JustinBSG/USB_Hub_SS_1to3_Routing_Practice/usb_c_ss_hub_1to3_v1/docs/USB-C-SS-Hub-Hand-Solder-BOM.xlsx

Sheet: BOM
Case C BOM — R5 datasheet support audit | USB-C 5 V / 3 A | 3 × 0.50 A allocation
2026-11-02: added missing bias/divider/clock/strap resistors, DIR pull-ups and reset supervisor. Cgrst DNP; decouplers allocated. Startup ramp/inrush conflict remains OPEN; see Datasheet_Check. New prices TBD.
Item | Qty | Ref des | MPN | Mfr | Description | Package | Cat | Unit USD | Ext USD | DNP | Note
1 | 1 | U1 | TUSB8041ARGCR | Texas Instruments | 4-port USB 3.1 Gen1 SuperSpeed hub | VQFN-64 | DATA | $5.40 | $5.40 |  | Use individual power control; PWRCTL_POL low, FULLPWRMGMTz low, GANGED low. Battery-charging straps low. PWRCTL1–3 qualify TPS2552 EN via U35–37. Configure honest bus-powered power descriptors; 0.5 A hardware budget does not guarantee arbitrary USB3 high-power device compatibility. R5: R1bias/R1vbt/R1vbb/R1xfb added; TEST and PWRCTL_POL low via4.7k. U38 now drives GRSTz; Cgrst DNP.
2 | 1 | Y1 | ABM8-24.000MHZ-B2-T | Abracon | 24.000 MHz crystal ±20 ppm | 3.2×2.5 | DATA | $0.55 | $0.55 |  | Next to XI/XO. Away from L32.
3 | 2 | C_y | GRM1555C1H270JA01D | Murata | 27 pF C0G crystal load | 0402 | PASS | $0.03 | $0.06 |  | Two 27 pF → ~13.5 pF series + ~3 pF stray ≈ 16.5 pF. Crystal is 18 pF CL. Use 27 pF only after frequency validation, or try ~30 pF if measured stray is ~3 pF. Verify on prototype.
4 | 1 | U2 | HD3SS3220RNHR | Texas Instruments | UP0 CC + 10 Gbps 2:1 SS mux, PORT=UFP | WQFN-30 | CC | $1.85 | $1.85 |  | Upstream UFP: PORT=GND, ADDR NC (GPIO), VDD5=SYS_5V, VCC33=standby 3.3 V from U33. OUT2 pulled to standby 3.3 V: LOW means 3 A detected. U34 inverts OUT2 → EN of U31/U32. ENn_CC low; ENn_MUX=OUT2. VBUS_DET through 900 kΩ to J1 VBUS. R5: DIR pull-up Rdir2 to own VCC33.
5 | 1 | U3 | HD3SS3220RNHR | Texas Instruments | DS1 CC + SS mux, PORT=DFP | WQFN-30 | CC | $1.85 | $1.85 |  | DFP: PORT=SYS_5V; CURRENT_MODE explicitly LOW (Default USB); ADDR NC. ENn_CC=U2 OUT2 (disable without 3 A source). ID goes to corresponding U35–37 OR gate. VCC33=main 3.3 V; VDD5=SYS_5V. Passive-cable power budget; active/VCONN loads are outside guarantee. R5: DIR pull-up Rdir3 to own VCC33. PORT high through 4.7 kΩ; ENn_MUX directly GND for normal operation when main VCC33 active.
6 | 1 | U4 | HD3SS3220RNHR | Texas Instruments | DS2 CC + SS mux, PORT=DFP | WQFN-30 | CC | $1.85 | $1.85 |  | DFP: PORT=SYS_5V; CURRENT_MODE explicitly LOW (Default USB); ADDR NC. ENn_CC=U2 OUT2 (disable without 3 A source). ID goes to corresponding U35–37 OR gate. VCC33=main 3.3 V; VDD5=SYS_5V. Passive-cable power budget; active/VCONN loads are outside guarantee. R5: DIR pull-up Rdir4 to own VCC33. PORT high through 4.7 kΩ; ENn_MUX directly GND for normal operation when main VCC33 active.
7 | 1 | U5 | HD3SS3220RNHR | Texas Instruments | DS3 CC + SS mux, PORT=DFP | WQFN-30 | CC | $1.85 | $1.85 |  | DFP: PORT=SYS_5V; CURRENT_MODE explicitly LOW (Default USB); ADDR NC. ENn_CC=U2 OUT2 (disable without 3 A source). ID goes to corresponding U35–37 OR gate. VCC33=main 3.3 V; VDD5=SYS_5V. Passive-cable power budget; active/VCONN loads are outside guarantee. R5: DIR pull-up Rdir5 to own VCC33. PORT high through 4.7 kΩ; ENn_MUX directly GND for normal operation when main VCC33 active.
8 | 1 | U6 | TPS2552DBVR | Texas Instruments | 5 V port switch; 0.50 A allocated load | SOT-23-6 | POWER | $0.85 | $0.85 |  | Active-low EN from OR of corresponding HD3 ID and U1 active-low PWRCTL. External 10 kΩ EN pull-up to SYS_5V keeps port off when logic unpowered. FAULT to corresponding OVERCURz; no direct ID-only enable.
9 | 1 | U7 | TPS2552DBVR | Texas Instruments | 5 V port switch; 0.50 A allocated load | SOT-23-6 | POWER | $0.85 | $0.85 |  | Active-low EN from OR of corresponding HD3 ID and U1 active-low PWRCTL. External 10 kΩ EN pull-up to SYS_5V keeps port off when logic unpowered. FAULT to corresponding OVERCURz; no direct ID-only enable.
10 | 1 | U8 | TPS2552DBVR | Texas Instruments | 5 V port switch; 0.50 A allocated load | SOT-23-6 | POWER | $0.85 | $0.85 |  | Active-low EN from OR of corresponding HD3 ID and U1 active-low PWRCTL. External 10 kΩ EN pull-up to SYS_5V keeps port off when logic unpowered. FAULT to corresponding OVERCURz; no direct ID-only enable.
11 | 3 | Rilim | RC0603FR-0743K2L | Yageo | 43.2 kΩ 1%: identical downstream limits | 0603 | PASS | TBD | TBD |  | Three identical values. TI equations including 1% R: ~0.544–0.673 A threshold, nominal ~0.606 A. Normal-load allocation 0.50 A per port; limit is protection, not a USB current advertisement.
12 | 1 | U31 | TLV75533PDBVR | Texas Instruments | SYS_5V → 3.3 V LDO 500 mA, hand-solder | SOT-23-5 | POWER | $0.36 | $0.36 |  | SOT-23 retained. EN=U34 output, with 100 kΩ pulldown. Powers U1 and U3–U5 main 3.3 V; U2 uses separate standby supply. 0.20 A design allowance; thermal validation remains required.
13 | 1 | C31i | GRM188R60J106ME47D | Murata | 10 µF 6.3 V X5R ±20% LDO VIN | 0603 | PASS | $0.08 | $0.08 |  | Verified R6/X5R ordering code; −55 to +85 °C. Check effective capacitance at rail bias, tolerance and temperature. Existing price estimate only. Check 5 V bias curve against regulator input requirement.
14 | 1 | C31o | GRM21BR61A226ME51L | Murata | 22 µF 10 V X5R ±20% LDO VOUT | 0805 | PASS | $0.08 | $0.08 |  | Verified part shared with Cblk5. Changed 0603 → 0805; footprint update required. Check effective C at 3.3 V against TLV755P requirements. Existing $0.08 estimate reused.
15 | 1 | U32 | TLV62569PDDCR | Texas Instruments | SYS_5V → 1.1 V buck 2 A 1.5 MHz, hand-solder | SOT-23-6 | POWER | $0.62 | $0.62 |  | SOT-23 retained; EN=U34 output with 100 kΩ pulldown. Main 1.1 V powers only after upstream advertises 3 A. 1 µH +2×22 µF retained. PG participates in rail-qualified hub reset; recommended VIN max 5.5 V.
16 | 1 | L32 | XFL4020-102MEC | Coilcraft | 1.0 µH shielded Isat 5.4 A (30 % drop) / 4.5 A (10 % drop) | 4×4×2.1 mm | POWER | $1.15 | $1.15 |  | Verified XFL4020-102MEC. Isat figures are Coilcraft drop criteria. Check height vs original 4015. Start winding on SW.
17 | 1 | C32i | GRM188R60J106ME47D | Murata | 10 µF 6.3 V X5R ±20% buck VIN | 0603 | PASS | $0.08 | $0.08 |  | Verified R6/X5R ordering code; −55 to +85 °C. Check effective capacitance at rail bias, tolerance and temperature. Existing price estimate only. At U32 VIN/GND; check 5 V bias curve.
18 | 2 | C32o | GRM21BR61A226ME51L | Murata | 22 µF 10 V X5R ±20% buck VOUT (each) | 0805 | PASS | $0.08 | $0.16 |  | 2 × 22 µF with L32 = 1 µH: TLV62569 Table 4 tested combination for 0.6 ≤ VOUT < 1.2 V. Changed 0603 → 0805. Verify bias/temperature derating; table allows +20/−50% capacitor tolerance/derating.
19 | 1 | R32t | RC0402FR-07124KL | Yageo | 124 kΩ 1% FB top → 1.096 V | 0402 | PASS | $0.02 | $0.02 |  | Vout=0.6×(1+R1/R2).
20 | 1 | R32b | RC0402FR-07150KL | Yageo | 150 kΩ 1% FB bottom to AGND | 0402 | PASS | $0.02 | $0.02 |  | Place at U32, not at the hub.
21 | 1 | FB32 | BLM18PG300SN1D | Murata | Ferrite 30 Ω @100 MHz; DCR ≤50 mΩ | 0603 | PASS | $0.10 | $0.10 |  | Retained. Maximum DCR 0.05 Ω gives 35 mV drop at 0.70 A. Check 1.1 V rail margin including regulator tolerance, PCB drop and transients before selecting a lower-DCR alternative.
22 | 1 | C32h | GRM188R60J106ME47D | Murata | 10 µF 6.3 V X5R ±20% after ferrite | 0603 | PASS | $0.08 | $0.08 |  | Verified R6/X5R ordering code; −55 to +85 °C. Check effective capacitance at rail bias, tolerance and temperature. Existing price estimate only. Changed 0402 → 0603; footprint update required.
23 | 1 | Rpg | RC0402FR-07100KL | Yageo | 100 kΩ PG pull-up to 3.3 V | 0402 | PASS | $0.02 | $0.02 |  | 100 kΩ U32 PG pull-up to main3.3V; PG drives U38 MR, not directly U1 GRSTz. U38 adds release delay. Check PG threshold and hub-side 1.1 V margin.
24 | 0 | Cgrst | GRM155R71C105KA12D | Murata | 1 µF GRSTz to GND | 0402 | PASS | $0.04 | $0.00 | DNP | R5: omit original 1 µF GRSTz capacitor. U38 drives reset with a timed release; do not fit an extra large load on RESET.
25 | 1 | U30 | TPS259470ARPWR | Texas Instruments | Input eFuse: reverse blocking, slew control, adjustable OVP | VQFN-HR-10 | POWER | TBD | TBD |  | Replaces Q1; not pin-compatible. J1 VBUS → IN, OUT → SYS_5V. RILM=1.33 kΩ (~2.5 A); ITIMER open, AUXOFF NC. 100 nF dVdt gives ~0.25 s nominal rise at 5 V; verify maximum capacitance/startup. FLT pull-up to standby 3.3 V. QFN needs reflow/hot air. CORRECTION: 250 ms ramp is not acceptable for HD3 VDD5; see Component_Support.
26 | 1 | J1 | 124019572112A | Amphenol ICC | INPUT Type-C 24p mid-mount 5 A | Mid-mount | CONN | $2.27 | $2.27 |  | UP0. Parallel all VBUS and all GND pins.
27 | 1 | J2 | 124019572112A | Amphenol ICC | OUTPUT DS1 Type-C 24p mid-mount 5 A | Mid-mount | CONN | $2.27 | $2.27
28 | 1 | J3 | 124019572112A | Amphenol ICC | OUTPUT DS2 Type-C 24p mid-mount 5 A | Mid-mount | CONN | $2.27 | $2.27
29 | 1 | J4 | 124019572112A | Amphenol ICC | OUTPUT DS3 Type-C 24p mid-mount 5 A | Mid-mount | CONN | $2.27 | $2.27
30 | 16 | Uesd_ss | TPD2EUSB30DRTR | Texas Instruments | 2-ch low-C SS ESD (4 per Type-C for full coverage) | DRT (3-pin) | PROT | $0.42 | $6.72 |  | <1 mm from connector pads. Covers all 8 SS conductors per port.
31 | 4 | Uesd_cc | TPD4E05U06DQAR | Texas Instruments | 4-ch ESD D+/D−/CC1/CC2 | USON-10 | PROT | $0.38 | $1.52
32 | 4 | Dtv | PESD5V0S1UL | Nexperia | 5 V TVS on each Type-C VBUS (ESD only) | SOD882 / DFN1006-2 | PROT | $0.08 | $0.32 |  | Retained ESD-only. U30 adds OVLO disconnect (~5.38 V nominal); not a guarantee against every transient. Validate downstream overshoot.
33 | 16 | Cac | GCM155R71C104KA55D | Murata | 100 nF 16 V SS TX AC-cap | 0402 | PASS | $0.04 | $0.64 |  | 4 per port. Follow HD3SS3220 side-of-mux.
34 | 4 | R900k | RC0402FR-07900KL | Yageo | 900 kΩ VBUS_DET | 0402 | PASS | $0.02 | $0.08
35 | 3 | R200k | RC0402FR-07200KL | Yageo | 200 kΩ pull-up on DS ID | 0402 | PASS | $0.02 | $0.06
36 | 3 | Cblk5 | GRM21BR61A226ME51L | Murata | 22 µF 10 V downstream VBUS only (J2–J4) | 0805 | PASS | $0.08 | $0.24 |  | Remove 22 µF directly across upstream J1. Only three downstream capacitors here; J1 uses new C30in 1 µF.
37 | 1 | Cbulk | 16SVP180MX | Panasonic | 180 µF 16 V OS-CON SYS_5V | 8 mm | PASS | $0.85 | $0.85 |  | 180 µF after U30, never directly on J1 VBUS. Include all SYS_5V capacitance in inrush test; main regulators/ports disabled until 3 A detected.
38 | 20 | C10u | GRM188R60J106ME47D | Murata | 10 µF 6.3 V X5R ±20% local decouple | 0603 | PASS | $0.08 | $1.60 |  | R5 planning allocation: U1 two rail bulk caps; U2–U5 two each (VCC33/VDD5), total10. Remaining10 retained as existing reserve, not required by this allocation. Exact DC-bias effective C and any VCONN bulk need validation.
39 | 26 | C100n | GRM155R71C104KA88D | Murata | 100 nF 16 V per power pin | 0402 | PASS | $0.02 | $0.52 |  | R5 allocated: U1=12 (8 VDD +4 VDD33); U2–U5=8 (VCC33/VDD5 each); U6–U8=6 (IN/OUT each). Total26, previously24. Logic C34–37 and supervisor C38 are separate rows.
40 | 1 | PCB | JLC04161H-7628 ENIG + stencil | JLCPCB | 4-layer 1.0 mm (preferred for mid-mount), 90 Ω coupon, ~80×50 mm | 4-layer | MECH | $18.00 | $18.00 |  | Mid-mount connector prefers 0.8–1.2 mm. Confirm drawing or change thickness.
41 | 4 | MH | R30-1000402 | Harwin | M3 female-female brass spacer 4 mm (screw not included) | M3 | MECH | $0.40 | $1.60 |  | Harwin R30-1000402 is the spacer only. Specify separate M3 screws if required.
42 | 1 | U33 | TPS70933DBVR | Texas Instruments | Standby 3.3 V LDO for U2 and U34 | SOT-23-5 | POWER | TBD | TBD |  | IN=SYS_5V, EN open per TI; OUT=3V3_STBY. Runs before U31/U32. Check <100 mA startup/standby budget.
43 | 1 | U34 | SN74LVC1G04DBVR | Texas Instruments | 3 A detection inverter | SOT-23-5 | CC | TBD | TBD |  | Powered by 3V3_STBY. Input=U2 OUT2, output=MAIN_ENABLE to U31/U32 EN. OUT2 high/default → off. Loss of 3 A disables main rails.
44 | 3 | U35,U36,U37 | SN74LVC1G32DBVR | Texas Instruments | Per-port ID OR active-low hub PWRCTL | SOT-23-5 | CC | TBD | TBD |  | Powered by main 3.3 V. ENn_i = ID_i OR PWRCTLn_i. Ioff support and external EN pull-ups required. Both inputs must be low to enable port.
45 | 1 | R30ilim | RC0603FR-071K33L | Yageo | 1.33 kΩ 1% eFuse current setting | 0603 | PASS | TBD | TBD |  | Nominal ~2.50 A, tolerance budget ~2.23–2.78 A incl 1% resistor. No guarantee to limit sub-microsecond peaks.
46 | 1 | R30ovt | RT0603BRD0734K8L | Yageo | 34.8 kΩ 0.1% OVLO top resistor | 0603 | PASS | TBD | TBD |  | J1 VBUS to OVLO. With 10 kΩ bottom: nominal 5.376 V; ~5.292–5.488 V using TI threshold and resistor tolerance (before leakage/transients).
47 | 1 | R30ovb | RT0603BRD0710KL | Yageo | 10 kΩ 0.1% OVLO bottom resistor | 0603 | PASS | TBD | TBD |  | OVLO to GND. Disconnects excessive input; no higher-voltage USB-PD negotiation.
48 | 1 | R30uvt | RC0603FR-0747KL | Yageo | 47 kΩ 1% input UVLO top | 0603 | PASS | TBD | TBD |  | J1 VBUS to EN/UVLO; with 20 kΩ bottom ~4.02 V rising.
49 | 1 | R30uvb | RC0603FR-0720KL | Yageo | 20 kΩ 1% input UVLO bottom | 0603 | PASS | TBD | TBD |  | EN/UVLO to GND. U30 starts independently of main enable to power U2 detection.
50 | 1 | C30dvdt | GRM155R71C104KA88D | Murata | 100 nF eFuse slew capacitor | 0402 | PASS | $0.02 | $0.02 |  | REVIEW REQUIRED: R4 100 nF dVdt gives ~250 ms nominal 5 V rise, conflicting with HD3SS3220 VDD5 ramp maximum 25 ms. Revise slew capacitor or supply sequencing and verify inrush before release.
51 | 1 | C30in | GRM155R71C105KA12D | Murata | 1 µF 16 V upstream input capacitor | 0402 | PASS | $0.04 | $0.04 |  | At J1/U30 input. Total raw VBUS capacitance must stay within USB attach limit; no 22 µF or bulk before U30.
52 | 1 | C33in | GRM155R71C105KA12D | Murata | 1 µF 16 V standby LDO input | 0402 | PASS | $0.04 | $0.04 |  | U33 IN to GND, after U30.
53 | 1 | C33out | GRM21BR61A226ME51L | Murata | 22 µF 10 V standby LDO output | 0805 | PASS | $0.08 | $0.08 |  | U33 OUT to GND; verify effective capacitance ≥2 µF and ESR against TPS709 requirements.
54 | 4 | C34,C35,C36,C37 | GRM155R71C104KA88D | Murata | 100 nF logic decoupling | 0402 | PASS | $0.02 | $0.08 |  | One at each logic IC supply.
55 | 5 | Rout2,Rflt30,Ren6,Ren7,Ren8 | RC0603FR-0710KL | Yageo | 10 kΩ 1% fail-safe pull-ups | 0603 | PASS | TBD | TBD |  | OUT2/FLT30 to standby 3.3 V; TPS2552 EN pins to SYS_5V.
56 | 2 | Ren31,Ren32 | RC0603FR-07100KL | Yageo | 100 kΩ 1% main-enable pulldowns | 0603 | PASS | TBD | TBD |  | EN of each main regulator to GND.
57 | 1 | R1bias | RC0603FR-079K53L | Yageo | 9.53 kΩ 1% USB reference resistor | 0603 | PASS | TBD | TBD |  | U1 USB_R1 pin 64 to GND; mandatory. TI pin functions and Fig.34. Close to IC.
58 | 1 | R1vbt | RC0603FR-0790K9L | Yageo | 90.9 kΩ 1% upstream VBUS divider top | 0603 | PASS | TBD | TBD |  | J1 VBUS → R1vbt → U1 USB_VBUS pin 48. Mandatory; distinct from HD3 VBUS_DET.
59 | 1 | R1vbb | RC0603FR-0710KL | Yageo | 10 kΩ 1% upstream VBUS divider bottom | 0603 | PASS | TBD | TBD |  | U1 USB_VBUS pin 48 to GND. 5 V input gives ~0.496 V; never connect pin directly to 5 V.
60 | 1 | R1xfb | RC0603FR-071ML | Yageo | 1 MΩ crystal feedback resistor | 0603 | PASS | TBD | TBD |  | Across U1 XI and XO, in parallel with Y1; follows TI Fig.34 crystal implementation.
61 | 2 | R1test,R1pol | RC0603FR-074K7L | Yageo | 4.7 kΩ explicit low straps | 0603 | PASS | TBD | TBD |  | R1test: U1 TEST pin49 to GND (TI Fig.34). R1pol: PWRCTL_POL pin41 to GND for active-low port power control. FULLPWRMGMTz/GANGED use internal pulldowns; charging straps use internal pulldowns.
62 | 4 | Rdir2,Rdir3,Rdir4,Rdir5 | RC0402FR-07200KL | Yageo | 200 kΩ DIR pull-ups for all USB-C muxes | 0402 | PASS | $0.02 | $0.08 |  | Each HD3 DIR pin11 to its own VCC33 rail: U2 standby; U3–U5 main. Datasheet explicitly requires DIR pull-up even if DIR not routed elsewhere.
63 | 3 | Rport3,Rport4,Rport5 | RC0603FR-074K7L | Yageo | 4.7 kΩ DFP PORT pull-ups | 0603 | PASS | TBD | TBD |  | U3/U4/U5 PORT pin4 to SYS_5V, per tri-level pull-up guidance. U2 PORT directly GND. CURRENT_MODE U3–U5 directly GND; ADDR open in GPIO mode.
64 | 1 | U38 | TPS3808G33DBVR | Texas Instruments | 3.3 V reset supervisor with manual-reset input | SOT-23-6 | POWER | TBD | TBD |  | VDD and SENSE to main3.3V; MR to U32 PG (Rpg pull-up retained); RESET to U1 GRSTz. CT open gives 12–28 ms delay (20 ms typical) after 3.3 V good and PG released. Verify hub-side 1.1 V including ferrite/drop; PG is not a precise remote rail monitor.
65 | 1 | R38reset | RC0603FR-0710KL | Yageo | 10 kΩ supervisor RESET pull-up | 0603 | PASS | TBD | TBD |  | U38 RESET/U1 GRSTz to main3.3V. Remove Cgrst from assembly; CT left open.
66 | 1 | C38 | GRM155R71C104KA88D | Murata | 100 nF U38 local supply bypass | 0402 | PASS | $0.02 | $0.02 |  | U38 VDD to GND close to pins; separate from the general C100n pool.
 |  |  |  |  |  |  | BOARD TOTAL |  | QUOTE REQUIRED
 |  |  |  |  |  |  | PRICED SUBTOTAL |  | 60.32
Category | Priced USD subtotal
DATA | 5.95
CC | 7.4
POWER | 4.68
PROT | 8.56
CONN | 9.08
PASS | 5.05
MECH | 19.6

Sheet: Buy_List
R5 purchase list — DNP excluded; new prices require quotes
MPN | Mfr | Total qty | Unit USD | Ext USD | Used on
TUSB8041ARGCR | Texas Instruments | 1 | $5.40 | $5.40 | U1
ABM8-24.000MHZ-B2-T | Abracon | 1 | $0.55 | $0.55 | Y1
GRM1555C1H270JA01D | Murata | 2 | $0.03 | $0.06 | C_y
HD3SS3220RNHR | Texas Instruments | 4 | $1.85 | $7.40 | U2, U3, U4, U5
TPS2552DBVR | Texas Instruments | 3 | $0.85 | $2.55 | U6, U7, U8
RC0603FR-0743K2L | Yageo | 3 | TBD | TBD | Rilim
TLV75533PDBVR | Texas Instruments | 1 | $0.36 | $0.36 | U31
GRM188R60J106ME47D | Murata | 23 | $0.08 | $1.84 | C31i, C32i, C32h, C10u
GRM21BR61A226ME51L | Murata | 7 | $0.08 | $0.56 | C31o, C32o, Cblk5, C33out
TLV62569PDDCR | Texas Instruments | 1 | $0.62 | $0.62 | U32
XFL4020-102MEC | Coilcraft | 1 | $1.15 | $1.15 | L32
RC0402FR-07124KL | Yageo | 1 | $0.02 | $0.02 | R32t
RC0402FR-07150KL | Yageo | 1 | $0.02 | $0.02 | R32b
BLM18PG300SN1D | Murata | 1 | $0.10 | $0.10 | FB32
RC0402FR-07100KL | Yageo | 1 | $0.02 | $0.02 | Rpg
TPS259470ARPWR | Texas Instruments | 1 | TBD | TBD | U30
124019572112A | Amphenol ICC | 4 | $2.27 | $9.08 | J1, J2, J3, J4
TPD2EUSB30DRTR | Texas Instruments | 16 | $0.42 | $6.72 | Uesd_ss
TPD4E05U06DQAR | Texas Instruments | 4 | $0.38 | $1.52 | Uesd_cc
PESD5V0S1UL | Nexperia | 4 | $0.08 | $0.32 | Dtv
GCM155R71C104KA55D | Murata | 16 | $0.04 | $0.64 | Cac
RC0402FR-07900KL | Yageo | 4 | $0.02 | $0.08 | R900k
RC0402FR-07200KL | Yageo | 7 | $0.02 | $0.14 | R200k, Rdir2,Rdir3,Rdir4,Rdir5
16SVP180MX | Panasonic | 1 | $0.85 | $0.85 | Cbulk
GRM155R71C104KA88D | Murata | 32 | $0.02 | $0.64 | C100n, C30dvdt, C34,C35,C36,C37, C38
JLC04161H-7628 ENIG + stencil | JLCPCB | 1 | $18.00 | $18.00 | PCB
R30-1000402 | Harwin | 4 | $0.40 | $1.60 | MH
TPS70933DBVR | Texas Instruments | 1 | TBD | TBD | U33
SN74LVC1G04DBVR | Texas Instruments | 1 | TBD | TBD | U34
SN74LVC1G32DBVR | Texas Instruments | 3 | TBD | TBD | U35,U36,U37
RC0603FR-071K33L | Yageo | 1 | TBD | TBD | R30ilim
RT0603BRD0734K8L | Yageo | 1 | TBD | TBD | R30ovt
RT0603BRD0710KL | Yageo | 1 | TBD | TBD | R30ovb
RC0603FR-0747KL | Yageo | 1 | TBD | TBD | R30uvt
RC0603FR-0720KL | Yageo | 1 | TBD | TBD | R30uvb
GRM155R71C105KA12D | Murata | 2 | $0.04 | $0.08 | C30in, C33in
RC0603FR-0710KL | Yageo | 7 | TBD | TBD | Rout2,Rflt30,Ren6,Ren7,Ren8, R1vbb, R38reset
RC0603FR-07100KL | Yageo | 2 | TBD | TBD | Ren31,Ren32
RC0603FR-079K53L | Yageo | 1 | TBD | TBD | R1bias
RC0603FR-0790K9L | Yageo | 1 | TBD | TBD | R1vbt
RC0603FR-071ML | Yageo | 1 | TBD | TBD | R1xfb
RC0603FR-074K7L | Yageo | 5 | TBD | TBD | R1test,R1pol, Rport3,Rport4,Rport5
TPS3808G33DBVR | Texas Instruments | 1 | TBD | TBD | U38
 |  |  | BUY TOTAL | QUOTE REQUIRED
 |  |  | PRICED SUBTOTAL | 60.32

Sheet: Spec
R5 specification — required support added; startup sequencing still open
Item | Value
Ports | J1 Type-C UFP input + J2 J3 J4 Type-C DFP output. No barrel. No MCU.
Data | USB 3.2 Gen1 5 Gbps via TUSB8041A + 4× HD3SS3220
Power in | ASSUMPTION: laptop/desktop USB-C data port advertising 5 V / 3 A. No barrel, no MCU, no PD negotiation. USB-A/default/1.5 A sources do not enable the main hub.
Power out each DS | All three ports may operate together at up to 0.50 A load each, passive cables. Equal fixed limits, not equal enforced consumption. Default USB CC advertisement only; do not advertise 1.5/3 A. USB descriptors/host allocation still apply.
3.3 V | U31 main 3.3 V supplies U1/U3–U5. New U33 standby 3.3 V supplies U2/U34 independently. MAIN_ENABLE from inverted U2 OUT2 enables U31/U32.
1.1 V | U32 1.096 V, 1 µH, 2×22 µF, FB32 retained. PG feeds U38 MR. U38 senses main3.3V and delays reset release12–28 ms after valid SENSE/MR; Cgrst DNP. Verify actual hub1.1V after ferrite.
Heat converters | U31 ~0.34 W at 5 V / 0.20 A. Budget 0.50 A total input current for board electronics/standby, excluding downstream VBUS loads. This is a design allowance to verify, not a measured maximum.
Power path | J1 VBUS → U30 TPS259470ARPWR → SYS_5V → bulk, U33, U31/U32, downstream switches. No direct bypass. RILM 1.33 kΩ; OVLO 34.8 kΩ/10 kΩ (0.1%); UVLO 47 kΩ/20 kΩ; dVdt 100 nF.
Hand solder | U31/U32/U33 and logic are SOT-23; U30 is 2×2 mm QFN requiring hot air/reflow. Existing QFN/USON assembly requirement remains.
Status | R5 includes mandatory support resistors and timed reset. Engineering BOM; not release-ready: eFuse ramp/HD3 VDD5 timing and pre-advertisement inrush need a coordinated startup redesign. 3 A source / 3×0.50 A target unchanged.
Startup / detach | U30 soft-starts SYS_5V; only U33/U2/U34 active initially. OUT2 pull-up fails to OFF; low only for detected 3 A. U34 enables main rails. OUT2 also disables downstream CC when source is insufficient. Test de-advertisement/detach and unpowered pin behavior.
Port control | Set U1 PWRCTL polarity active-low, individual switching and no charging advertisement. Each port ENn=HD3 ID OR hub PWRCTLn through U35–37. External EN pull-ups keep switches off when gates unpowered. Faults report individually.
Before release | Verify three 0.50 A loads together, startup with bulk, source fallback, short circuit isolation, reverse leakage, OVLO overshoot, thermal margins and far-port VBUS under cable/trace drops. USB power descriptors must match actual bus-powered behavior; physical 0.50 A capability is not a compliance claim.
Source A | https://www.ti.com/lit/ds/symlink/tps25947.pdf
Source B | https://www.ti.com/lit/ds/symlink/hd3ss3220.pdf
Source C | https://www.ti.com/lit/ds/symlink/tps2553.pdf
Source D | https://www.ti.com/lit/ds/symlink/tps709.pdf
Source E | https://www.ti.com/lit/ds/symlink/sn74lvc1g32.pdf
Source allowance (A) | 3.000
Per-port normal allocation (A) | 0.500
Port count | 3.000
Electronics reserve (A) | 0.500
Normal aggregate (A) | 2.000
Headroom to source (A) | 1.000
Port threshold minimum (A) | 0.544
Port threshold maximum (A) | 0.673
Input limit nominal (A) | 2.496

Sheet: Changes
BOM corrections — R4 power selection; earlier rounds below are history
Item | What was wrong | Correction applied
DNP column | Engineering notes written into K (DNP) | Moved to Note (L); K cleared
CURRENT_MODE | L9 still said 3 A advert | Removed; only Default USB current remains
ESD formulas | J34, Buy_List C/E hard-coded | Restored =B34*I34 and SUMIF formulas
U32 note | Called 5.5 V absolute max | Corrected: recommended max 5.5 V, abs-max 6 V
Dtv note | Obsolete TPS62822 reference | Replaced with ESD-only + VCL warning
Crystal note | Claimed 27 pF + 3 pF = 18 pF | Corrected arithmetic (~16.5 pF); validation note added
MH description | Said standoff + screw | Now spacer only; screws separate
Rilim description | Still said TPS2553 | Updated to TPS2552
L32 Isat | 5.4 A without criterion | Added 30 % / 10 % drop figures
Q1 policy | Optional but included in total | Explicit baseline-include note
C32o | 2 ×10 µF not the Table 4 tested pair at 1.096 V with 1 µH | Use 2 ×22 µF GRM21BR61A226ME51L, 10 V X5R 0805; check effective capacitance.
C31o | Exact old 22 µF MPN unverified | Use GRM21BR61A226ME51L, shared with Cblk5; package changes 0603 →0805.
C31i / C32i | Exact R7 high-capacitance codes unverified | Select documented GRM188R60J106ME47D: 10 µF 6.3 V X5R 0603, ±20%, +85 °C max.
C32h / C10u | Old exact code unverified; similar R6 0402 candidate is mobile-only | Select same general-use 0603 10 µF part. Footprint changes 0402 →0603. Check rail-specific bias derating.
Q1 / input path | VBUS_DET incorrectly treated as high-side gate drive | Remove drive claim. Q1 remains HOLD/cost placeholder; reverse blocking and inrush solution require selection. No unqualified eFuse substitution.
Power / heat / bead | Source watts and worst-case heat were overstated; DCR wording too strict | Remove guaranteed input watts; state aggregate-budget requirement, conditional heat estimate, ΨJT method and DCR ≤50 mΩ.
Purchasing / cost | Replacement parts require grouped quantities and consistent prices | Rebuild Buy_List from BOM; 28 unique MPNs. Retain unquoted estimates; 0603 uses existing $0.08, 22 µF uses existing $0.08. Q1 remains in estimated total.
Open qualification | explanation.txt identifies conditional risks | Retain SOT-23 converters, bead, 27 pF crystal loads, TVS and 180 µF bulk. Validate thermal, voltage margins, oscillator, OVP need and inrush before release.
Source: buck | TI TLV62569 datasheet, Table 4 | https://www.ti.com/lit/ds/symlink/tlv62569.pdf
Source: 10 µF | Murata exact R6 / D packaging code; general-use 0603 | https://search.murata.co.jp/Ceramy/image/img/A01X/G101/ENG/GRM188R60J106ME47-61A.pdf
Source: 22 µF | Murata 22 µF 10 V X5R 0805; L packaging code | https://search.murata.co.jp/Ceramy/image/img/A01X/G101/ENG/GRM21BR61A226ME51-01A.pdf
Source: excluded 0402 | GRM155R60J106ME15: restricted to mobile devices | https://search.murata.co.jp/Ceramy/image/img/A01X/G101/ENG/GRM155R60J106ME15-01A.pdf
Source: thermal | TI thermal metrics guidance; ΨJT use | https://www.ti.com/lit/an/spra953d/spra953d.pdf
R4 input path | Q1 did not provide a complete protected path | Replace with U30 TPS259470ARPWR + setting resistors/capacitor. See Spec for required connections.
R4 source policy | Computer type alone does not define current allowance | Assume 3 A-advertising USB-C. Add standby LDO + inverter; lower-power source leaves main hub disabled.
R4 equal ports | ~1 A limits could overrun the shared source | 43.2 kΩ identical ILIM resistors; allocate 0.50 A per port simultaneously with passive cables.
R4 startup/control | Direct attachment-to-EN bypassed hub control | Add three OR gates; qualify attachment with hub PWRCTL. Move upstream 22 µF behind protection; J1 input 1 µF.
R4 price/status | New components have no verified quote | New prices TBD; total shows QUOTE REQUIRED. Prototype verification and USB configuration remain required.
Support tables · 2026-11-02 | Need passive parts grouped by IC | Added 20 sections for U1–U8, U30–U37 and J1–J4, plus Power_Guide. Linked MPNs and BOM quantities; pooled/shared parts explicitly identified.
Review correction | Earlier R4 proposal has unresolved mandatory support | Flagged absent U1 reference/divider resistors and 250 ms vs 25 ms HD3 supply-ramp conflict. No unverified replacement value or purchase quantity added.
R5 datasheet audit | Missing support identified across main ICs | Added U1 reference/VBUS/clock/test/polarity resistors; HD3 DIR and PORT pull-ups; U38 reset supervisor with pull-up and bypass.
R5 decoupling/reset | Unallocated pool and capacitor-only reset | C100n increased24→26 and allocated. C38 added separately. Cgrst qty0/DNP. Rpg now feeds U38 MR. Buy_List regenerated.
R5 remaining limitation | Startup cannot be fixed by a blind capacitor swap | 100 nF eFuse ramp conflicts with HD3 25 ms maximum. Faster ramp may exceed source allowance before3 A detection; bulk capacitance/startup sequencing must be redesigned together.

Sheet: Component_Support
Main components and their supporting parts
Read-only mapping of R4 selections; not extra purchase quantities. Each section is one main component. BOM quantities and MPNs are linked. Missing and unallocated items are explicitly flagged.
R5: missing reference/clock/strap/DIR parts and reset supervisor added below; 100 nF pool allocated. Existing startup ramp/inrush conflict remains OPEN; see Datasheet_Check.
U1 · TUSB8041A hub
Main 3.3 V and 1.1 V; central data hub. Sources [1], [2].
Supporting part / value | Qty here | BOM row qty | MPN | BOM reference group | Connection / purpose | Status
Y1 · 24 MHz crystal | 1 | 1 | ABM8-24.000MHZ-B2-T | Y1 | XI ↔ crystal ↔ XO; physical proximity matters. | Assigned in BOM
C_y · 27 pF C0G | 2 | 2 | GRM1555C1H270JA01D | C_y | One from each crystal terminal to GND. Existing value; validate actual load/frequency. | Assigned; value validation
R1bias · 9.53 kΩ ±1% | 1 | 1 | RC0603FR-079K53L | R1bias | U1 USB_R1 pin64 to GND. | Added / allocated in R5
R1vbt · 90.9 kΩ ±1% | 1 | 1 | RC0603FR-0790K9L | R1vbt | J1 VBUS to U1 USB_VBUS pin48. | Added / allocated in R5
R1vbb · 10 kΩ ±1% | 1 | 1 | RC0603FR-0710KL | R1vbb | U1 USB_VBUS pin48 to GND. | Added / allocated in R5
Cgrst · 1 µF — DO NOT FIT | 0 | 0 | GRM155R71C105KA12D | Cgrst | Superseded by U38 timed-reset circuit. | DNP in R5
C100n · 100 nF decouplers | 12 | 26 | GRM155R71C104KA88D | C100n | 12 from pool: eight 1.1 V VDD and four 3.3 V VDD33 pins. | Allocated from 26-piece pool
C10u · 10 µF local bulk | 2 | 20 | GRM188R60J106ME47D | C10u | Two per IC block from existing20-piece pool: one on each supply rail. 10 allocated overall; 10 existing reserve. Verify effective C. | Planning allocation; bias check
FB32 · ferrite | 1 | 1 | BLM18PG300SN1D | FB32 | Shared 1.1 V path from U32; also shown under U32. Same physical part. | Shared reference; count once
C32h · 10 µF | 1 | 1 | GRM188R60J106ME47D | C32h | Hub side of FB32 to GND; also shown under U32. | Shared reference; count once
Configuration straps / reset qualification | TBD |  | Not selected | Not in purchasing BOM | R1test/R1pol 4.7k pulldowns added. FULLPWRMGMTz/GANGED and battery-charge settings use internal pulldowns. U38 reset section below. | Assigned in R5
U2 · HD3SS3220
Upstream J1; VCC33 from standby rail. VDD5 from SYS_5V. Sources [2].
Supporting part / value | Qty here | BOM row qty | MPN | BOM reference group | Connection / purpose | Status
R900k · 900 kΩ | 1 | 4 | RC0402FR-07900KL | R900k | J1 VBUS through resistor to VBUS_DET; one of four total. | Assigned in BOM
Rout2 · 10 kΩ | 1 | 5 | RC0603FR-0710KL | Rout2,Rflt30,Ren6,Ren7,Ren8 | OUT2 to standby 3.3 V; input to U34. One of the five grouped 10 kΩ resistors. | Assigned in BOM
C100n · 100 nF | 2 | 26 | GRM155R71C104KA88D | C100n | Two from pool: one VDD5 and one VCC33 bypass. | Allocated from 26-piece pool
C10u · 10 µF | 2 | 20 | GRM188R60J106ME47D | C10u | Two per IC block from existing20-piece pool: one on each supply rail. 10 allocated overall; 10 existing reserve. Verify effective C. | Planning allocation; bias check
Cac · 100 nF TX coupling | 4 | 16 | GCM155R71C104KA55D | Cac | Four per connector interface in current BOM; assign to TX paths per HD3 reference. Avoid duplicate TX coupling; these are signal capacitors, not power bypass. | Interface allocation; verify
PORT / CURRENT_MODE / ADDR straps | TBD |  | Not selected | Not in purchasing BOM | PORT tied GND, ADDR open; ENn_CC low; ENn_MUX per source-detection policy. DIR pull-up added below. | Assigned in R5
SYS_5V supply ramp | — |  | Not selected | Not in purchasing BOM | R4 C30dvdt=100 nF gives ~250 ms nominal. HD3 VDD5 ramp maximum is 25 ms. Revise slew/startup topology before release. | REVIEW REQUIRED
U3 · HD3SS3220
Downstream J3; VCC33 from main rail. VDD5 from SYS_5V. Sources [2].
Supporting part / value | Qty here | BOM row qty | MPN | BOM reference group | Connection / purpose | Status
R900k · 900 kΩ | 1 | 4 | RC0402FR-07900KL | R900k | J3 VBUS through resistor to VBUS_DET; one of four total. | Assigned in BOM
R200k · 200 kΩ | 1 | 3 | RC0402FR-07200KL | R200k | ID to main 3.3 V; one of three. ID feeds U35 logic gate. | Assigned in BOM
C100n · 100 nF | 2 | 26 | GRM155R71C104KA88D | C100n | Two from pool: one VDD5 and one VCC33 bypass. | Allocated from 26-piece pool
C10u · 10 µF | 2 | 20 | GRM188R60J106ME47D | C10u | Two per IC block from existing20-piece pool: one on each supply rail. 10 allocated overall; 10 existing reserve. Verify effective C. | Planning allocation; bias check
Cac · 100 nF TX coupling | 4 | 16 | GCM155R71C104KA55D | Cac | Four per connector interface in current BOM; assign to TX paths per HD3 reference. Avoid duplicate TX coupling; these are signal capacitors, not power bypass. | Interface allocation; verify
PORT / CURRENT_MODE / ADDR straps | TBD |  | Not selected | Not in purchasing BOM | Rport3–5: one4.7k toSYS_5V per PORT pin; CURRENT_MODE GND; ADDR open; ENn_MUX GND. DIR pull-ups added below. | Assigned in R5
SYS_5V supply ramp | — |  | Not selected | Not in purchasing BOM | R4 C30dvdt=100 nF gives ~250 ms nominal. HD3 VDD5 ramp maximum is 25 ms. Revise slew/startup topology before release. | REVIEW REQUIRED
U4 · HD3SS3220
Downstream J4; VCC33 from main rail. VDD5 from SYS_5V. Sources [2].
Supporting part / value | Qty here | BOM row qty | MPN | BOM reference group | Connection / purpose | Status
R900k · 900 kΩ | 1 | 4 | RC0402FR-07900KL | R900k | J4 VBUS through resistor to VBUS_DET; one of four total. | Assigned in BOM
R200k · 200 kΩ | 1 | 3 | RC0402FR-07200KL | R200k | ID to main 3.3 V; one of three. ID feeds U36 logic gate. | Assigned in BOM
C100n · 100 nF | 2 | 26 | GRM155R71C104KA88D | C100n | Two from pool: one VDD5 and one VCC33 bypass. | Allocated from 26-piece pool
C10u · 10 µF | 2 | 20 | GRM188R60J106ME47D | C10u | Two per IC block from existing20-piece pool: one on each supply rail. 10 allocated overall; 10 existing reserve. Verify effective C. | Planning allocation; bias check
Cac · 100 nF TX coupling | 4 | 16 | GCM155R71C104KA55D | Cac | Four per connector interface in current BOM; assign to TX paths per HD3 reference. Avoid duplicate TX coupling; these are signal capacitors, not power bypass. | Interface allocation; verify
PORT / CURRENT_MODE / ADDR straps | TBD |  | Not selected | Not in purchasing BOM | Rport3–5: one4.7k toSYS_5V per PORT pin; CURRENT_MODE GND; ADDR open; ENn_MUX GND. DIR pull-ups added below. | Assigned in R5
SYS_5V supply ramp | — |  | Not selected | Not in purchasing BOM | R4 C30dvdt=100 nF gives ~250 ms nominal. HD3 VDD5 ramp maximum is 25 ms. Revise slew/startup topology before release. | REVIEW REQUIRED
U5 · HD3SS3220
Downstream J5; VCC33 from main rail. VDD5 from SYS_5V. Sources [2].
Supporting part / value | Qty here | BOM row qty | MPN | BOM reference group | Connection / purpose | Status
R900k · 900 kΩ | 1 | 4 | RC0402FR-07900KL | R900k | J5 VBUS through resistor to VBUS_DET; one of four total. | Assigned in BOM
R200k · 200 kΩ | 1 | 3 | RC0402FR-07200KL | R200k | ID to main 3.3 V; one of three. ID feeds U37 logic gate. | Assigned in BOM
C100n · 100 nF | 2 | 26 | GRM155R71C104KA88D | C100n | Two from pool: one VDD5 and one VCC33 bypass. | Allocated from 26-piece pool
C10u · 10 µF | 2 | 20 | GRM188R60J106ME47D | C10u | Two per IC block from existing20-piece pool: one on each supply rail. 10 allocated overall; 10 existing reserve. Verify effective C. | Planning allocation; bias check
Cac · 100 nF TX coupling | 4 | 16 | GCM155R71C104KA55D | Cac | Four per connector interface in current BOM; assign to TX paths per HD3 reference. Avoid duplicate TX coupling; these are signal capacitors, not power bypass. | Interface allocation; verify
PORT / CURRENT_MODE / ADDR straps | TBD |  | Not selected | Not in purchasing BOM | Rport3–5: one4.7k toSYS_5V per PORT pin; CURRENT_MODE GND; ADDR open; ENn_MUX GND. DIR pull-ups added below. | Assigned in R5
SYS_5V supply ramp | — |  | Not selected | Not in purchasing BOM | R4 C30dvdt=100 nF gives ~250 ms nominal. HD3 VDD5 ramp maximum is 25 ms. Revise slew/startup topology before release. | REVIEW REQUIRED
U6 · TPS2552
Power switch for J2; 0.50 A normal allocation. Source [3].
Supporting part / value | Qty here | BOM row qty | MPN | BOM reference group | Connection / purpose | Status
Rilim · 43.2 kΩ ±1% | 1 | 3 | RC0603FR-0743K2L | Rilim | ILIM to GND. One of three matched settings; threshold ~0.544–0.673 A incl resistor tolerance. | Assigned in BOM
Ren6 · 10 kΩ | 1 | 5 | RC0603FR-0710KL | Rout2,Rflt30,Ren6,Ren7,Ren8 | EN to SYS_5V: fail-safe OFF when logic is unpowered. One of five grouped resistors. | Assigned in BOM
Cblk5 · 22 µF 10 V | 1 | 3 | GRM21BR61A226ME51L | Cblk5 | Switched J2 VBUS to GND; one of three downstream output capacitors. | Assigned in BOM
C100n · 100 nF input bypass | 2 | 26 | GRM155R71C104KA88D | C100n | Two from pool: one IN and one OUT bypass. | Allocated from 26-piece pool
FAULT pull-up | Conditional |  | Not selected | Not in purchasing BOM | FAULT is open drain, connected to U1 OVERCURz (internal pull-up). Check whether an external pull-up is needed; do not count Rflt30 as this resistor. | Check signal pull-up
Control from U35 | — |  | Not selected | Not in purchasing BOM | OR gate combines HD3 ID and U1 active-low PWRCTL. No inductor or output voltage-setting divider is used. | Connection reference
U7 · TPS2552
Power switch for J3; 0.50 A normal allocation. Source [3].
Supporting part / value | Qty here | BOM row qty | MPN | BOM reference group | Connection / purpose | Status
Rilim · 43.2 kΩ ±1% | 1 | 3 | RC0603FR-0743K2L | Rilim | ILIM to GND. One of three matched settings; threshold ~0.544–0.673 A incl resistor tolerance. | Assigned in BOM
Ren7 · 10 kΩ | 1 | 5 | RC0603FR-0710KL | Rout2,Rflt30,Ren6,Ren7,Ren8 | EN to SYS_5V: fail-safe OFF when logic is unpowered. One of five grouped resistors. | Assigned in BOM
Cblk5 · 22 µF 10 V | 1 | 3 | GRM21BR61A226ME51L | Cblk5 | Switched J3 VBUS to GND; one of three downstream output capacitors. | Assigned in BOM
C100n · 100 nF input bypass | 2 | 26 | GRM155R71C104KA88D | C100n | Two from pool: one IN and one OUT bypass. | Allocated from 26-piece pool
FAULT pull-up | Conditional |  | Not selected | Not in purchasing BOM | FAULT is open drain, connected to U1 OVERCURz (internal pull-up). Check whether an external pull-up is needed; do not count Rflt30 as this resistor. | Check signal pull-up
Control from U36 | — |  | Not selected | Not in purchasing BOM | OR gate combines HD3 ID and U1 active-low PWRCTL. No inductor or output voltage-setting divider is used. | Connection reference
U8 · TPS2552
Power switch for J4; 0.50 A normal allocation. Source [3].
Supporting part / value | Qty here | BOM row qty | MPN | BOM reference group | Connection / purpose | Status
Rilim · 43.2 kΩ ±1% | 1 | 3 | RC0603FR-0743K2L | Rilim | ILIM to GND. One of three matched settings; threshold ~0.544–0.673 A incl resistor tolerance. | Assigned in BOM
Ren8 · 10 kΩ | 1 | 5 | RC0603FR-0710KL | Rout2,Rflt30,Ren6,Ren7,Ren8 | EN to SYS_5V: fail-safe OFF when logic is unpowered. One of five grouped resistors. | Assigned in BOM
Cblk5 · 22 µF 10 V | 1 | 3 | GRM21BR61A226ME51L | Cblk5 | Switched J4 VBUS to GND; one of three downstream output capacitors. | Assigned in BOM
C100n · 100 nF input bypass | 2 | 26 | GRM155R71C104KA88D | C100n | Two from pool: one IN and one OUT bypass. | Allocated from 26-piece pool
FAULT pull-up | Conditional |  | Not selected | Not in purchasing BOM | FAULT is open drain, connected to U1 OVERCURz (internal pull-up). Check whether an external pull-up is needed; do not count Rflt30 as this resistor. | Check signal pull-up
Control from U37 | — |  | Not selected | Not in purchasing BOM | OR gate combines HD3 ID and U1 active-low PWRCTL. No inductor or output voltage-setting divider is used. | Connection reference
U30 · TPS259470 input eFuse
J1 VBUS → U30 → SYS_5V. Source [4].
Supporting part / value | Qty here | BOM row qty | MPN | BOM reference group | Connection / purpose | Status
C30in · 1 µF | 1 | 1 | GRM155R71C105KA12D | C30in | IN/J1 VBUS to GND; keep large bulk after U30. | Assigned in BOM
Cbulk · 180 µF | 1 | 1 | 16SVP180MX | Cbulk | OUT/SYS_5V to GND; shared reservoir for downstream loads. | Assigned in BOM
R30ilim · 1.33 kΩ | 1 | 1 | RC0603FR-071K33L | R30ilim | ILM to GND; sets ~2.5 A nominal aggregate protection. | Assigned in BOM
R30ovt · 34.8 kΩ 0.1% | 1 | 1 | RT0603BRD0734K8L | R30ovt | J1 VBUS to OVLO. | Assigned in BOM
R30ovb · 10 kΩ 0.1% | 1 | 1 | RT0603BRD0710KL | R30ovb | OVLO to GND; pair sets ~5.376 V nominal cutoff. | Assigned in BOM
R30uvt · 47 kΩ | 1 | 1 | RC0603FR-0747KL | R30uvt | J1 VBUS to EN/UVLO. | Assigned in BOM
R30uvb · 20 kΩ | 1 | 1 | RC0603FR-0720KL | R30uvb | EN/UVLO to GND; pair sets ~4.02 V nominal start threshold. | Assigned in BOM
C30dvdt · 100 nF | 1 | 1 | GRM155R71C104KA88D | C30dvdt | dVdt to GND. R4 nominal ~250 ms ramp conflicts with HD3 VDD5 25 ms limit. Value/topology must be revised with inrush analysis. | REVIEW REQUIRED
Rflt30 · 10 kΩ | 1 | 5 | RC0603FR-0710KL | Rout2,Rflt30,Ren6,Ren7,Ren8 | FLT to standby 3.3 V. One of five grouped pull-ups. | Assigned in BOM
ITIMER / AUXOFF | 0 |  | Not selected | Not in purchasing BOM | R4 leaves both open; no timer capacitor or external series MOSFET selected. | No passive assigned
U31 · TLV75533 main 3.3 V
Fixed-output linear regulator; no inductor or voltage-setting divider. Source [5].
Supporting part / value | Qty here | BOM row qty | MPN | BOM reference group | Connection / purpose | Status
C31i · 10 µF 6.3 V | 1 | 1 | GRM188R60J106ME47D | C31i | VIN/SYS_5V to GND; check effective C at bias. | Assigned in BOM
C31o · 22 µF 10 V | 1 | 1 | GRM21BR61A226ME51L | C31o | 3.3 V OUT to GND. | Assigned in BOM
Ren31 · 100 kΩ | 1 | 2 | RC0603FR-07100KL | Ren31,Ren32 | EN to GND; U34 drives EN. One of two grouped pulldowns. | Assigned in BOM
U32 · TLV62569P 1.1 V buck
Switching regulator; output filter and feedback set core voltage. Source [6].
Supporting part / value | Qty here | BOM row qty | MPN | BOM reference group | Connection / purpose | Status
C32i · 10 µF | 1 | 1 | GRM188R60J106ME47D | C32i | VIN to GND close to IC. | Assigned in BOM
L32 · 1 µH | 1 | 1 | XFL4020-102MEC | L32 | SW to buck output node; energy-storage inductor. | Assigned in BOM
C32o · 22 µF each | 2 | 2 | GRM21BR61A226ME51L | C32o | Buck output node to GND, before FB32; total 44 µF nominal. | Assigned in BOM
R32t · 124 kΩ | 1 | 1 | RC0402FR-07124KL | R32t | Buck output node to FB. | Assigned in BOM
R32b · 150 kΩ | 1 | 1 | RC0402FR-07150KL | R32b | FB to quiet GND; 0.6 × (1 + 124/150) = 1.096 V. | Assigned in BOM
Rpg · 100 kΩ | 1 | 1 | RC0402FR-07100KL | Rpg | PG pulled to main3.3V; drives U38 MR. U38 RESET drives hub GRSTz. | Assigned in BOM
Ren32 · 100 kΩ | 1 | 2 | RC0603FR-07100KL | Ren31,Ren32 | EN to GND; one of two grouped pulldowns. | Assigned in BOM
FB32 · ferrite | 1 | 1 | BLM18PG300SN1D | FB32 | Buck output to hub 1.1 V island. Same part shown under U1. | Shared reference; count once
C32h · 10 µF | 1 | 1 | GRM188R60J106ME47D | C32h | After ferrite to GND; same part shown under U1. | Shared reference; count once
U33 · TPS70933 standby 3.3 V
Powers U2/U34 before main converters start. Source [7].
Supporting part / value | Qty here | BOM row qty | MPN | BOM reference group | Connection / purpose | Status
C33in · 1 µF | 1 | 1 | GRM155R71C105KA12D | C33in | IN/SYS_5V to GND. | Assigned in BOM
C33out · 22 µF | 1 | 1 | GRM21BR61A226ME51L | C33out | OUT/3V3_STBY to GND; verify effective capacitance and ESR. | Assigned in BOM
EN / output-setting components | 0 |  | Not selected | Not in purchasing BOM | Fixed 3.3 V version; EN left open per R4/TI internal enable behavior. No feedback divider or inductor. | No additional passive
U34 · SN74LVC1G04 inverter
Converts U2 active-low 3 A detection into active-high MAIN_ENABLE. Source [8].
Supporting part / value | Qty here | BOM row qty | MPN | BOM reference group | Connection / purpose | Status
C34 · 100 nF | 1 | 4 | GRM155R71C104KA88D | C34,C35,C36,C37 | Standby 3.3 V supply to GND close to U34. | Assigned in BOM
Rout2 · 10 kΩ | 1 | 5 | RC0603FR-0710KL | Rout2,Rflt30,Ren6,Ren7,Ren8 | Shared OUT2 pull-up shown under U2; count once. | Shared reference; count once
Output pulldowns | See U31/U32 |  | Not selected | Not in purchasing BOM | Ren31 and Ren32 already assigned to the regulator EN pins; no extra duplicate resistors. | Connection reference
U35 · SN74LVC1G32 OR gate
Controls U6 for J2. Source [9].
Supporting part / value | Qty here | BOM row qty | MPN | BOM reference group | Connection / purpose | Status
C35 · 100 nF | 1 | 4 | GRM155R71C104KA88D | C34,C35,C36,C37 | Main 3.3 V supply to GND close to gate. | Assigned in BOM
Input / output bias resistors | See associated ICs |  | Not selected | Not in purchasing BOM | HD3 ID uses R200k; output uses Ren6. Already assigned in controller/switch sections. Do not duplicate. | Connection reference
U36 · SN74LVC1G32 OR gate
Controls U7 for J3. Source [9].
Supporting part / value | Qty here | BOM row qty | MPN | BOM reference group | Connection / purpose | Status
C36 · 100 nF | 1 | 4 | GRM155R71C104KA88D | C34,C35,C36,C37 | Main 3.3 V supply to GND close to gate. | Assigned in BOM
Input / output bias resistors | See associated ICs |  | Not selected | Not in purchasing BOM | HD3 ID uses R200k; output uses Ren7. Already assigned in controller/switch sections. Do not duplicate. | Connection reference
U37 · SN74LVC1G32 OR gate
Controls U8 for J4. Source [9].
Supporting part / value | Qty here | BOM row qty | MPN | BOM reference group | Connection / purpose | Status
C37 · 100 nF | 1 | 4 | GRM155R71C104KA88D | C34,C35,C36,C37 | Main 3.3 V supply to GND close to gate. | Assigned in BOM
Input / output bias resistors | See associated ICs |  | Not selected | Not in purchasing BOM | HD3 ID uses R200k; output uses Ren8. Already assigned in controller/switch sections. Do not duplicate. | Connection reference
J1 · USB-C connector
Upstream input; protection components included for context, although ESD arrays are ICs.
Supporting part / value | Qty here | BOM row qty | MPN | BOM reference group | Connection / purpose | Status
Dtv · PESD5V0S1UL | 1 | 4 | PESD5V0S1UL | Dtv | VBUS to GND, ESD-only; one per connector. | Assigned in BOM
Uesd_ss · TPD2EUSB30 | 4 | 16 | TPD2EUSB30DRTR | Uesd_ss | Protect eight SuperSpeed conductors; shunt protection, not a series power path. | Assigned in BOM
Uesd_cc · TPD4E05U06 | 1 | 4 | TPD4E05U06DQAR | Uesd_cc | Protect D+/D−/CC1/CC2. | Assigned in BOM
C30in · 1 µF | 1 | 1 | GRM155R71C105KA12D | C30in | Same upstream capacitor listed under U30. | Shared reference; count once
J2 · USB-C connector
Downstream output; protection components included for context, although ESD arrays are ICs.
Supporting part / value | Qty here | BOM row qty | MPN | BOM reference group | Connection / purpose | Status
Dtv · PESD5V0S1UL | 1 | 4 | PESD5V0S1UL | Dtv | VBUS to GND, ESD-only; one per connector. | Assigned in BOM
Uesd_ss · TPD2EUSB30 | 4 | 16 | TPD2EUSB30DRTR | Uesd_ss | Protect eight SuperSpeed conductors; shunt protection, not a series power path. | Assigned in BOM
Uesd_cc · TPD4E05U06 | 1 | 4 | TPD4E05U06DQAR | Uesd_cc | Protect D+/D−/CC1/CC2. | Assigned in BOM
Cblk5 · 22 µF | 1 | 3 | GRM21BR61A226ME51L | Cblk5 | Same output capacitor listed under corresponding power switch. | Shared reference; count once
J3 · USB-C connector
Downstream output; protection components included for context, although ESD arrays are ICs.
Supporting part / value | Qty here | BOM row qty | MPN | BOM reference group | Connection / purpose | Status
Dtv · PESD5V0S1UL | 1 | 4 | PESD5V0S1UL | Dtv | VBUS to GND, ESD-only; one per connector. | Assigned in BOM
Uesd_ss · TPD2EUSB30 | 4 | 16 | TPD2EUSB30DRTR | Uesd_ss | Protect eight SuperSpeed conductors; shunt protection, not a series power path. | Assigned in BOM
Uesd_cc · TPD4E05U06 | 1 | 4 | TPD4E05U06DQAR | Uesd_cc | Protect D+/D−/CC1/CC2. | Assigned in BOM
Cblk5 · 22 µF | 1 | 3 | GRM21BR61A226ME51L | Cblk5 | Same output capacitor listed under corresponding power switch. | Shared reference; count once
J4 · USB-C connector
Downstream output; protection components included for context, although ESD arrays are ICs.
Supporting part / value | Qty here | BOM row qty | MPN | BOM reference group | Connection / purpose | Status
Dtv · PESD5V0S1UL | 1 | 4 | PESD5V0S1UL | Dtv | VBUS to GND, ESD-only; one per connector. | Assigned in BOM
Uesd_ss · TPD2EUSB30 | 4 | 16 | TPD2EUSB30DRTR | Uesd_ss | Protect eight SuperSpeed conductors; shunt protection, not a series power path. | Assigned in BOM
Uesd_cc · TPD4E05U06 | 1 | 4 | TPD4E05U06DQAR | Uesd_cc | Protect D+/D−/CC1/CC2. | Assigned in BOM
Cblk5 · 22 µF | 1 | 3 | GRM21BR61A226ME51L | Cblk5 | Same output capacitor listed under corresponding power switch. | Shared reference; count once
[1] U1 hub | https://www.ti.com/lit/ds/symlink/tusb8041a.pdf
[2] USB-C controller | https://www.ti.com/lit/ds/symlink/hd3ss3220.pdf
[3] Port switches | https://www.ti.com/lit/ds/symlink/tps2553.pdf
[4] Input eFuse | https://www.ti.com/lit/ds/symlink/tps25947.pdf
[5] Main 3.3 V LDO | https://www.ti.com/lit/ds/symlink/tlv755p.pdf
[6] Buck converter | https://www.ti.com/lit/ds/symlink/tlv62569.pdf
[7] Standby regulator | https://www.ti.com/lit/ds/symlink/tps709.pdf
[8] Inverter | https://www.ti.com/lit/ds/symlink/sn74lvc1g04.pdf
[9] OR gates | https://www.ti.com/lit/ds/symlink/sn74lvc1g32.pdf
[10] Type-C vs USB PD | https://www.ti.com/lit/eb/slyy228/slyy228.pdf
R5 added support parts — counted in BOM / Buy_List
1 MΩ crystal feedback resistor | 1 | 1 | RC0603FR-071ML | R1xfb | Across U1 XI and XO, in parallel with Y1; follows TI Fig.34 crystal implementation. | Added / allocated in R5
4.7 kΩ explicit low straps | 2 | 2 | RC0603FR-074K7L | R1test,R1pol | R1test: U1 TEST pin49 to GND (TI Fig.34). R1pol: PWRCTL_POL pin41 to GND for active-low port power control. FULLPWRMGMTz/GANGED use internal pulldowns; charging straps use internal pulldowns. | Added / allocated in R5
200 kΩ DIR pull-ups for all USB-C muxes | 4 | 4 | RC0402FR-07200KL | Rdir2,Rdir3,Rdir4,Rdir5 | Each HD3 DIR pin11 to its own VCC33 rail: U2 standby; U3–U5 main. Datasheet explicitly requires DIR pull-up even if DIR not routed elsewhere. | Added / allocated in R5
4.7 kΩ DFP PORT pull-ups | 3 | 3 | RC0603FR-074K7L | Rport3,Rport4,Rport5 | U3/U4/U5 PORT pin4 to SYS_5V, per tri-level pull-up guidance. U2 PORT directly GND. CURRENT_MODE U3–U5 directly GND; ADDR open in GPIO mode. | Added / allocated in R5
3.3 V reset supervisor with manual-reset input | 1 | 1 | TPS3808G33DBVR | U38 | VDD and SENSE to main3.3V; MR to U32 PG (Rpg pull-up retained); RESET to U1 GRSTz. CT open gives 12–28 ms delay (20 ms typical) after 3.3 V good and PG released. Verify hub-side 1.1 V including ferrite/drop; PG is not a precise remote rail monitor. | Added / allocated in R5
10 kΩ supervisor RESET pull-up | 1 | 1 | RC0603FR-0710KL | R38reset | U38 RESET/U1 GRSTz to main3.3V. Remove Cgrst from assembly; CT left open. | Added / allocated in R5
100 nF U38 local supply bypass | 1 | 1 | GRM155R71C104KA88D | C38 | U38 VDD to GND close to pins; separate from the general C100n pool. | Added / allocated in R5

Sheet: Power_Guide
Power distribution explained | R4 confirmed target: computer USB-C 5 V / 3 A, three equal 0.50 A normal-load allocations, passive cables.
Voltage versus current | Voltage is electrical potential; current is what the connected load draws. All three outputs are parallel branches at nominal 5 V, sharing ground. The voltage is not divided into 5/3 V.
Power | Power = voltage × current. At nominal 5 V, each 0.50 A port is allocated 2.5 W; three total 7.5 W. Actual connector voltage is lower due to cable, trace and switch losses.
USB-C current advertisement | The source advertises Default USB / 1.5 A / 3 A using CC. U2 detects this. A 3 A advertisement means permission to draw up to that level, not forced current. Source [2], [10].
USB Power Delivery (USB PD) | PD is a separate message-based power negotiation protocol. R4 does not implement PD contracts, higher voltage negotiation or laptop charging pass-through. It uses Type-C 5 V current advertisement. Source [10].
Protection is not negotiation | U30 protects the input. Its ~2.5 A limit is below the source 3 A allowance, but does not request power from the computer. U2 checks source capability; U30 is not a PD controller.
Port limit is not advertisement | The 0.50 A figure is the chosen normal-load budget. TPS2552 trip/limit threshold is higher (~0.544–0.673 A), providing tolerance margin. Downstream CC remains Default USB; descriptor/enumeration requirements still apply.
Input branch | J1 VBUS → U30 → SYS_5V. U30 controls startup and isolates reverse current/overvoltage. The 180 µF reservoir is after U30.
Three output branches | SYS_5V → U6 → J2; SYS_5V → U7 → J3; SYS_5V → U8 → J4. Each can be enabled independently. Equal resistor settings give equal nominal limits, not identical instantaneous currents.
Internal power branches | U31: 5 V → main 3.3 V. U32: 5 V → 1.096 V, then ferrite to U1. U33: 5 V → standby 3.3 V for U2/U34. Port power does not pass through the 3.3 V or 1.1 V regulators.
Standby / main startup | Intended: U30 starts SYS_5V → U33 powers U2/U34 → U2 detects 3 A → U34 enables U31/U32 → valid rails release hub reset → attachment AND hub command enable each output. Current R4 slew timing must first be corrected.
If source is insufficient | Main rails and downstream ports remain off; standby source detection stays active. The diagram is a proposed policy; loss of advertisement and startup sequencing require testing.
Example of unequal consumption | If devices draw 0.10 A, 0.30 A and 0.50 A, output total is 0.90 A. Unused budget is not forced into the first two devices and is not automatically added to another port limit.
Capacitors | Small decouplers supply fast local current and reduce supply noise. Bulk capacitors help during load changes but draw charging current at plug-in. Signal AC-coupling capacitors have a different purpose: block DC in SuperSpeed paths.
Inductor versus ferrite | L32 stores energy each switching cycle in the buck converter. FB32 attenuates high-frequency rail noise; its DC resistance also causes voltage drop. They are not interchangeable.
Resistors | Feedback resistors set U32 voltage. ILIM resistors set current protection. OVLO/UVLO dividers set eFuse voltage thresholds. Pull-ups/pulldowns set known logic states. Crystal capacitors set oscillator loading.
Heat | U31 dissipates approximately (5−3.3)×0.20 = 0.34 W at the design load. U32 switches efficiently, so its 1.1 V output current is not equal to its 5 V input current. Use power/efficiency when budgeting across different voltages.
R5 support additions | R5 added R1bias (9.53 kΩ), R1vbt (90.9 kΩ), R1vbb (10 kΩ), crystal feedback resistor, mode straps and HD3 DIR pull-ups. U38 now supervises main3.3V and waits for U32 PG before releasing hub reset.
Important correction: startup ramp | R4 selected 100 nF dVdt (~250 ms nominal 5 V rise), while HD3SS3220 requires VDD5 ramp ≤25 ms. Revise capacitor or power sequencing topology and verify worst-case ramp plus USB inrush. Current selection is not validated.
What the budget does not prove | No guarantee for arbitrary high-power USB3 devices, active/VCONN cables, exact 5.00 V at the load, or fault isolation under every transient. USB configuration, voltage-drop and thermal checks remain required.
Budget at nominal 5 V | Value
Source current allowance (A) | 3.000
Per-port load allocation (A) | 0.500
Number of output ports | 3.000
Board input-current reserve (A) | 0.500
Outputs total current (A) | 1.500
Normal total input budget (A) | 2.000
Source-side headroom (A) | 1.000
Outputs total power (W) | 7.500
Nominal source capability (W) | 15.000
Input eFuse nominal limit (A) | 2.496
Sources | Manufacturer links [1]–[10] are at the bottom of Component_Support. Budget reserve is a design allowance, not measured consumption.

Sheet: Datasheet_Check
R5 datasheet-to-BOM support audit · 2026-11-02
Review covers all main IC families, the new supervisor, ESD devices and crystal. It checks support requirements for selected modes; it is not a netlist, USB-compliance or production-release sign-off.
Device / references | Datasheet location | Result / BOM action | Remaining status | Manufacturer source
U1 · TUSB8041A | Pin table; Fig.34; sections8.3.7,10,11 | Added 9.53k reference,90.9k/10k divider,1M crystal feedback,TEST/PWRCTL_POL low straps.12 decouplers allocated. U38 selected for reset. | Support added; clock load and hub voltage still validate | https://www.ti.com/lit/ds/symlink/tusb8041a.pdf
U2–U5 · HD3SS3220 | Pin functions; recommended conditions; applications | Added4×200k DIR pull-ups and3×4.7k DFP PORT pull-ups. Existing900k sense,ID pulls,AC caps retained;8 bypass caps allocated. | OPEN: SYS_5V ramp; VCONN outside power guarantee | https://www.ti.com/lit/ds/symlink/hd3ss3220.pdf
U6–U8 · TPS2552 | Pin functions; sections8.5.1,9.2; power recommendations | Existing43.2k ILIM,EN pulls,22uF outputs retained. Allocate six100nF caps: IN and OUT per switch. FAULT uses U1 internal OVERCURz pull-up. | No other mandatory passive found for selected mode | https://www.ti.com/lit/ds/symlink/tps2553.pdf
U30 · TPS259470A | Recommended conditions; dVdt/ILIM/OVLO application | Required input/output caps,ILIM,UVLO/OVLO resistors andFLT pull-up already listed. ITIMER/AUXOFF open per selected mode. | OPEN:100nF gives~250ms; HD3 max25ms. Do not blindly substitute smaller C; validate pre-advertisement current and bulk. | https://www.ti.com/lit/ds/symlink/tps25947.pdf
U31 · TLV75533P | Input/output capacitor requirements | Existing10uF input22uF output andEN pulldown present. Fixed3.3V needs no divider/inductor. | No mandatory part missing; effective C/thermal validate | https://www.ti.com/lit/ds/symlink/tlv755p.pdf
U32 · TLV62569P | Application Table4; feedback/PG | Existing1uH,2×22uF,10uF input,124k/150k feedback,PG pull-up,EN pulldown present. PG now goes to supervisor MR. | No missing regulator support found; hub-side voltage validate | https://www.ti.com/lit/ds/symlink/tlv62569.pdf
U33 · TPS70933 | Input/output capacitor selection; EN | Existing1uF input22uF output present; EN open allowed. For3.3V output: effective C≥1.5uF,≤47uF,ESR0–0.2Ω. | No mandatory part missing; verify derating/ESR | https://www.ti.com/lit/ds/symlink/tps709.pdf
U34 · SN74LVC1G04 | Application; bypass and input conditions | C34 100nF present; inputOUT2 pull-up present. Outputs feed existing regulator pulldowns. | No mandatory support missing; check input transition timing | https://www.ti.com/lit/ds/symlink/sn74lvc1g04.pdf
U35–U37 · SN74LVC1G32 | Application; bypass/input conditions | C35–37 100nF present. Inputs driven byID/PWRCTL; outputs EN pull-ups present; Ioff supports partial-power-down. | No additional part required for selected logic; verify startup states | https://www.ti.com/lit/ds/symlink/sn74lvc1g32.pdf
U38 · TPS3808G33 (new) | Pin functions; timing table; reset application | SOT23 supervisor +100nF VDD bypass +10k RESET pull-up. VDD/SENSE main3.3V; MR=U32 PG; CT open.12–28ms release delay. Cgrst not fitted. | Selected implementation; validate supply transitions and core margin | https://www.ti.com/lit/ds/symlink/tps3808.pdf
Uesd_ss · TPD2EUSB30 | Application and pin descriptions | Passive shunt ESD array, no supply capacitor or programming resistor required.16 arrays retained. | No additional support part required | https://www.ti.com/lit/ds/symlink/tpd2eusb30.pdf
Uesd_cc · TPD4E05U06 | Application and pin descriptions | Passive shunt ESD array.4 arrays retained; no separate supply/bias resistor. | No additional support part required | https://www.ti.com/lit/ds/symlink/tpd4e05u06.pdf
Dtv · PESD5V0S1UL | Ratings and application | Standalone shunt ESD diode; no programming/bypass parts. Retain ESD-only label. | No supporting part missing; not sustained OVP | https://assets.nexperia.com/documents/data-sheet/PESD5V0S1UL.pdf
Y1 · ABM8 24MHz B2 | Abracon ordering guide; TI crystal requirements | 18pF CL standard;24MHz fundamental,50Ω ESR max; two27pF loads retained with frequency-check note.1M feedback added per TI reference. | Prototype frequency/drive validation remains | https://abracon.com/Resonators/abm8.pdf
