JustinBSG/USB_Hub_SS_1to3_Routing_Practice/usb_c_ss_hub_1to3_v1/docs/USB-C-SS-Hub-Case-C-BOM-Hand-Solder.xlsx

Sheet: BOM
Case C complete BOM — 1 Type-C in + 3 Type-C out | SOT-23 LDO 3.3 V + SOT-23 buck 1.1 V
No MCU. No barrel. Host 5 V only. Hand-solder converters: TLV75533PDBVR (5→3.3 SOT-23-5) + TLV62569PDDCR (5→1.1 SOT-23-6). Size 1.1 V for 0.70 A (563 mA typ 3×SS U0). USD qty-1 cut-tape ballpark. Yellow = inputs. Ext = Qty×Unit.
Item | Qty | Ref des | MPN | Mfr | Description | Package | Cat | Unit USD | Ext USD | DNP | Note
1 | 1 | U1 | TUSB8041ARGCR | Texas Instruments | 4-port USB 3.1 Gen1 SuperSpeed hub | VQFN-64 | DATA | $5.40 |  |  | SDA/SCL floating. SMBUSz NC. GRSTz = 1 µF to GND, released after 3.3 V and 1.1 V up.
2 | 1 | Y1 | ABM8-24.000MHZ-B2-T | Abracon | 24.000 MHz crystal ±20 ppm | 3.2×2.5 | DATA | $0.55 |  |  | Next to XI/XO. Away from L32.
3 | 2 | C_y | GRM1555C1H270JA01D | Murata | 27 pF C0G crystal load | 0402 | PASS | $0.03 |  |  | Two 27 pF → ~13.5 pF series + ~3 pF stray ≈ 16.5 pF. Crystal is 18 pF CL. Use 27 pF only after frequency validation, or try ~30 pF if measured stray is ~3 pF. Verify on prototype.
4 | 1 | U2 | HD3SS3220RNHR | Texas Instruments | UP0 CC + 10 Gbps 2:1 SS mux, PORT=UFP | WQFN-30 | CC | $1.85 |  |  | PORT to GND. VBUS_DET 900 kΩ to J1 VBUS.
5 | 1 | U3 | HD3SS3220RNHR | Texas Instruments | DS1 CC + SS mux, PORT=DFP | WQFN-30 | CC | $1.85 |  |  | PORT to 5 V. CURRENT_MODE floating or low = Default USB current (~0.9 A typical). ID → U6 EN (active-low). Do not set CURRENT_MODE high.
6 | 1 | U4 | HD3SS3220RNHR | Texas Instruments | DS2 CC + SS mux, PORT=DFP | WQFN-30 | CC | $1.85 |  |  | ID → U7 EN (active-low).
7 | 1 | U5 | HD3SS3220RNHR | Texas Instruments | DS3 CC + SS mux, PORT=DFP | WQFN-30 | CC | $1.85 |  |  | ID → U8 EN (active-low).
8 | 1 | U6 | TPS2552DBVR | Texas Instruments | DS VBUS switch ~1.0 A, active-low EN | SOT-23-6 | POWER | $0.85 |  |  | FAULT# → OVERCURxz. EN driven by HD3SS3220 ID (low = enable).
9 | 1 | U7 | TPS2552DBVR | Texas Instruments | DS VBUS switch ~1.0 A, active-low EN | SOT-23-6 | POWER | $0.85 |  |  | FAULT# → OVERCURxz. EN driven by HD3SS3220 ID (low = enable).
10 | 1 | U8 | TPS2552DBVR | Texas Instruments | DS VBUS switch ~1.0 A, active-low EN | SOT-23-6 | POWER | $0.85 |  |  | FAULT# → OVERCURxz. EN driven by HD3SS3220 ID (low = enable).
11 | 3 | Rilim | RC0402FR-0724K9L | Yageo | 24.9 kΩ 1% TPS2552 ILIM | 0402 | PASS | $0.03 |  |  | ≈ 1.0 A nominal (see datasheet min/max with 1 % R). Do not leave ILIM open.
12 | 1 | U31 | TLV75533PDBVR | Texas Instruments | SYS_5V → 3.3 V LDO 500 mA, hand-solder | SOT-23-5 | POWER | $0.36 |  |  | Same TLV755P as WSON. Gull-wing SOT-23-5. EN to SYS_5V. Quiet rail for VDD33 + four VCC33. Load ≤ 0.20 A.
13 | 1 | C31i | GRM188R70J106ME47D | Murata | 10 µF 6.3 V LDO VIN | 0603 | PASS | $0.08
14 | 1 | C31o | GRM188R70J226ME47D | Murata | 22 µF 6.3 V LDO VOUT | 0603 | PASS | $0.12
15 | 1 | U32 | TLV62569PDDCR | Texas Instruments | SYS_5V → 1.1 V buck 2 A 1.5 MHz, hand-solder | SOT-23-6 | POWER | $0.62 |  |  | Replaces TPS62822 VSON. PG pin gates GRSTz. Recommended VIN max 5.5 V; absolute maximum 6 V. η ~85–90 % at 5→1.1 V / 0.7 A. Keep-out island opposite Type-C / Y1. Size Iout 0.70 A.
16 | 1 | L32 | XFL4020-102MEC | Coilcraft | 1.0 µH shielded Isat 5.4 A (30 % drop) / 4.5 A (10 % drop) | 4×4×2.1 mm | POWER | $1.15 |  |  | Verified XFL4020-102MEC. Isat figures are Coilcraft drop criteria. Check height vs original 4015. Start winding on SW.
17 | 1 | C32i | GRM188R70J106ME47D | Murata | 10 µF 6.3 V buck VIN at VIN/PGND | 0603 | PASS | $0.08 |  |  | First part next to U32 VIN/GND. SOT-23 still wants Cin touching the pins.
18 | 2 | C32o | GRM188R70J106ME47D | Murata | 10 µF 6.3 V buck VOUT | 0603 | PASS | $0.08
19 | 1 | R32t | RC0402FR-07124KL | Yageo | 124 kΩ 1% FB top → 1.096 V | 0402 | PASS | $0.02 |  |  | Vout=0.6×(1+R1/R2).
20 | 1 | R32b | RC0402FR-07150KL | Yageo | 150 kΩ 1% FB bottom to AGND | 0402 | PASS | $0.02 |  |  | Place at U32, not at the hub.
21 | 1 | FB32 | BLM18PG300SN1D | Murata | Ferrite 30 Ω@100 MHz DCR~40 mΩ on 1.1 V | 0603 | PASS | $0.10 |  |  | DCR < 50 mΩ. Do not use a high-DCR EMI bead.
22 | 1 | C32h | GRM155R70J106ME15D | Murata | 10 µF after ferrite on hub VDD island | 0402 | PASS | $0.03
23 | 1 | Rpg | RC0402FR-07100KL | Yageo | 100 kΩ PG pull-up to 3.3 V | 0402 | PASS | $0.02 |  |  | PG pull-up to 3.3 V on TLV62569P pin. Do not float if you use PG→GRSTz.
24 | 1 | Cgrst | GRM155R71C105KA12D | Murata | 1 µF GRSTz to GND | 0402 | PASS | $0.04 |  |  | Hold reset until 3.3 V and 1.1 V are up.
25 | 1 | Q1 | CSD17313Q2 | Texas Instruments | N-FET reverse-block SYS_5V | SON-6 | POWER | $0.45 |  |  | Optional reverse-blocking FET. Include in baseline total unless explicitly marked DNP. Gate from UP0 VBUS detect; validate body-diode orientation and drive.
26 | 1 | J1 | 124019572112A | Amphenol ICC | INPUT Type-C 24p mid-mount 5 A | Mid-mount | CONN | $2.27 |  |  | UP0. Parallel all VBUS and all GND pins.
27 | 1 | J2 | 124019572112A | Amphenol ICC | OUTPUT DS1 Type-C 24p mid-mount 5 A | Mid-mount | CONN | $2.27
28 | 1 | J3 | 124019572112A | Amphenol ICC | OUTPUT DS2 Type-C 24p mid-mount 5 A | Mid-mount | CONN | $2.27
29 | 1 | J4 | 124019572112A | Amphenol ICC | OUTPUT DS3 Type-C 24p mid-mount 5 A | Mid-mount | CONN | $2.27
30 | 16 | Uesd_ss | TPD2EUSB30DRTR | Texas Instruments | 2-ch low-C SS ESD (4 per Type-C for full coverage) | DRT (3-pin) | PROT | $0.42 |  |  | <1 mm from connector pads. Covers all 8 SS conductors per port.
31 | 4 | Uesd_cc | TPD4E05U06DQAR | Texas Instruments | 4-ch ESD D+/D−/CC1/CC2 | USON-10 | PROT | $0.38
32 | 4 | Dtv | PESD5V0S1UL | Nexperia | 5 V TVS on each Type-C VBUS (ESD only) | SOD882 / DFN1006-2 | PROT | $0.08 |  |  | ESD protection only. Package is SOD882 / DFN1006-2. VBR ≥ 6.4 V so it does not reliably clamp below TLV62569 6 V absolute maximum. Consider dedicated OVP if sustained over-voltage protection is required.
33 | 16 | Cac | GCM155R71C104KA55D | Murata | 100 nF 16 V SS TX AC-cap | 0402 | PASS | $0.04 |  |  | 4 per port. Follow HD3SS3220 side-of-mux.
34 | 4 | R900k | RC0402FR-07900KL | Yageo | 900 kΩ VBUS_DET | 0402 | PASS | $0.02
35 | 3 | R200k | RC0402FR-07200KL | Yageo | 200 kΩ pull-up on DS ID | 0402 | PASS | $0.02
36 | 4 | Cblk5 | GRM21BR61A226ME51L | Murata | 22 µF 10 V on each Type-C VBUS | 0805 | PASS | $0.08
37 | 1 | Cbulk | 16SVP180MX | Panasonic | 180 µF 16 V OS-CON SYS_5V | 8 mm | PASS | $0.85 |  |  | USB hub bulk ≥120 µF.
38 | 20 | C10u | GRM155R70J106ME15D | Murata | 10 µF 6.3 V local decouple | 0402 | PASS | $0.03 |  |  | Under every QFN. Extra to island ceramics.
39 | 24 | C100n | GRM155R71C104KA88D | Murata | 100 nF 16 V per power pin | 0402 | PASS | $0.02
40 | 1 | PCB | JLC04161H-7628 ENIG + stencil | JLCPCB | 4-layer 1.0 mm (preferred for mid-mount), 90 Ω coupon, ~80×50 mm | 4-layer | MECH | $18.00 |  |  | Mid-mount connector prefers 0.8–1.2 mm. Confirm drawing or change thickness.
41 | 4 | MH | R30-1000402 | Harwin | M3 female-female brass spacer 4 mm (screw not included) | M3 | MECH | $0.40 |  |  | Harwin R30-1000402 is the spacer only. Specify separate M3 screws if required.
 |  |  |  |  |  |  | BOARD TOTAL
By category
Category | Ext USD | Share
DATA
CC
POWER
PROT
CONN
PASS
MECH

Sheet: Buy_List
Case C buy list — one row per MPN
MPN | Mfr | Total qty | Unit USD | Ext USD | Used on
TUSB8041ARGCR | Texas Instruments |  |  |  | U1
ABM8-24.000MHZ-B2-T | Abracon |  |  |  | Y1
GRM1555C1H270JA01D | Murata |  |  |  | C_y
HD3SS3220RNHR | Texas Instruments |  |  |  | U2, U3, U4, U5
TPS2552DBVR | Texas Instruments |  |  |  | U6, U7, U8
RC0402FR-0724K9L | Yageo |  |  |  | Rilim
TLV75533PDBVR | Texas Instruments |  |  |  | U31
GRM188R70J106ME47D | Murata |  |  |  | C31i, C32i, C32o
GRM188R70J226ME47D | Murata |  |  |  | C31o
TLV62569PDDCR | Texas Instruments |  |  |  | U32
XFL4020-102MEC | Coilcraft |  |  |  | L32
RC0402FR-07124KL | Yageo |  |  |  | R32t
RC0402FR-07150KL | Yageo |  |  |  | R32b
BLM18PG300SN1D | Murata |  |  |  | FB32
GRM155R70J106ME15D | Murata |  |  |  | C32h, C10u
RC0402FR-07100KL | Yageo |  |  |  | Rpg
GRM155R71C105KA12D | Murata |  |  |  | Cgrst
CSD17313Q2 | Texas Instruments |  |  |  | Q1
124019572112A | Amphenol ICC |  |  |  | J1, J2, J3, J4
TPD2EUSB30DRTR | Texas Instruments |  |  |  | Uesd_ss
TPD4E05U06DQAR | Texas Instruments |  |  |  | Uesd_cc
PESD5V0S1UL | Nexperia |  |  |  | Dtv
GCM155R71C104KA55D | Murata |  |  |  | Cac
RC0402FR-07900KL | Yageo |  |  |  | R900k
RC0402FR-07200KL | Yageo |  |  |  | R200k
GRM21BR61A226ME51L | Murata |  |  |  | Cblk5
16SVP180MX | Panasonic |  |  |  | Cbulk
GRM155R71C104KA88D | Murata |  |  |  | C100n
JLC04161H-7628 ENIG + stencil | JLCPCB |  |  |  | PCB (consider 1.0 mm for mid-mount)
R30-1000402 | Harwin |  |  |  | MH
 |  |  | BUY TOTAL
Must match BOM board total

Sheet: Spec
Case C locked spec
Item | Value
Ports | J1 Type-C UFP input + J2 J3 J4 Type-C DFP output. No barrel. No MCU.
Data | USB 3.2 Gen1 5 Gbps via TUSB8041A + 4× HD3SS3220
Power in | Host J1 VBUS 5 V only (7.5–15 W typical)
Power out each DS | 5 V, TPS2552 ILIM ≈ 1.0 A (active-low). CURRENT_MODE = Default USB current. Three ports share leftover host watts.
3.3 V | TLV75533PDBVR LDO SOT-23-5, load ≤ 0.20 A (check thermal at 0.34 W)
1.1 V | TLV62569PDDCR buck SOT-23-6, size 0.70 A (563 mA typ 3× SS U0)
Heat converters | ~0.45–0.50 W worst case (LDO 0.34 W + buck ~0.12 W)
Layout | L32 1 µH + U32 opposite Type-C edge. Not under SS pairs or Y1.
Hand solder | Both converters are SOT-23 gull-wing. Iron + flux. No hot-bar required.
Was / now | Was WSON TLV75533PDRVR + VSON TPS62822 + 470 nH. Now SOT-23 + verified 1 µH + TPS2552 active-low.

Sheet: Changes
BOM Corrections Applied — Round 2 (problem-2.txt)
Item | What was wrong | Correction applied
DNP column | Engineering notes written into K (DNP) | Moved to Note (L); K cleared
CURRENT_MODE | L9 still said 3 A advert | Removed; only Default USB current remains
ESD formulas | J34, Buy_List C/E hard-coded | Restored =B34*I34 and SUMIF formulas
U32 note | Called 5.5 V absolute max | Corrected: recommended max 5.5 V, abs-max 6 V
Dtv note | Obsolete TPS62822 reference | Replaced with ESD-only + VCL warning
Crystal note | Claimed 27 pF + 3 pF = 18 pF | Corrected arithmetic (~16.5 pF); validation note added
MH description | Said standoff + screw | Now spacer only; screws separate
Rilim description | Still said TPS2553 | Updated to TPS2552
L32 Isat | 5.4 A without criterion | Added 30 % / 10 % drop figures
Q1 policy | Optional but included in total | Explicit baseline-include note
