JustinBSG/USB_Hub_SS_1to3_Routing_Practice/(commit log)

2026-09-21 chore: first commit
    [USB-C-SS-Hub-4Port-BOM.xlsx]
2026-09-22 doc: add BOM list
    [USB-C-SS-Hub-4Port-BOM.xlsx]
2026-09-22 doc:add BOM list for hand soldering
    [USB-C-SS-Hub-Case-C-BOM-Hand-Solder.xlsx]
2026-09-22 chore: reconstruct the file structure
    [USB-C-SS-Hub-4Port-BOM.xlsx, USB-C-SS-Hub-Case-C-BOM-Hand-Solder.xlsx]
2026-09-22 docs: update docs for main ICs
    [USB-C-SS-Hub-Case-C-BOM-Hand-Solder.xlsx, WBBOMDesign22.csv]
2026-10-27 feat: init kicad prj
2026-11-01 chore: add footprint and symbol of all ic
2026-11-02 docs: edit BOM List
2026-11-02 docs: update problem.txt for BOM list
2026-11-02 docs: update BOM list
2026-11-02 feat: comfirm the BOM List and update the latest version the BOM List
2026-11-02 feat: update BOM list for greater readability
2026-11-02 feat:update BOM list, add missing res and cap
2026-11-02 docs: update all docs and footprint and symbol
